zt-chen/voltpillager/docs/README.md

# Voltpillager Website 

Voltpillager Website build with cayman theme
