zt-chen/voltpillager/additional/stability/stability.pdf

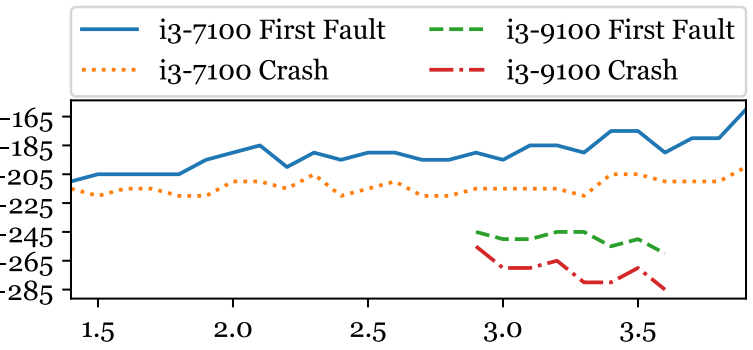
[picture p9: figure]
i3-7100 First Fault i3-7100 Crash; i3-9100 First Fault i3-9100 Crash

### Frequency (GHz)

### Undervolting (mV)
