zt-chen/voltpillager/docs/voltpillager-photo.jpeg

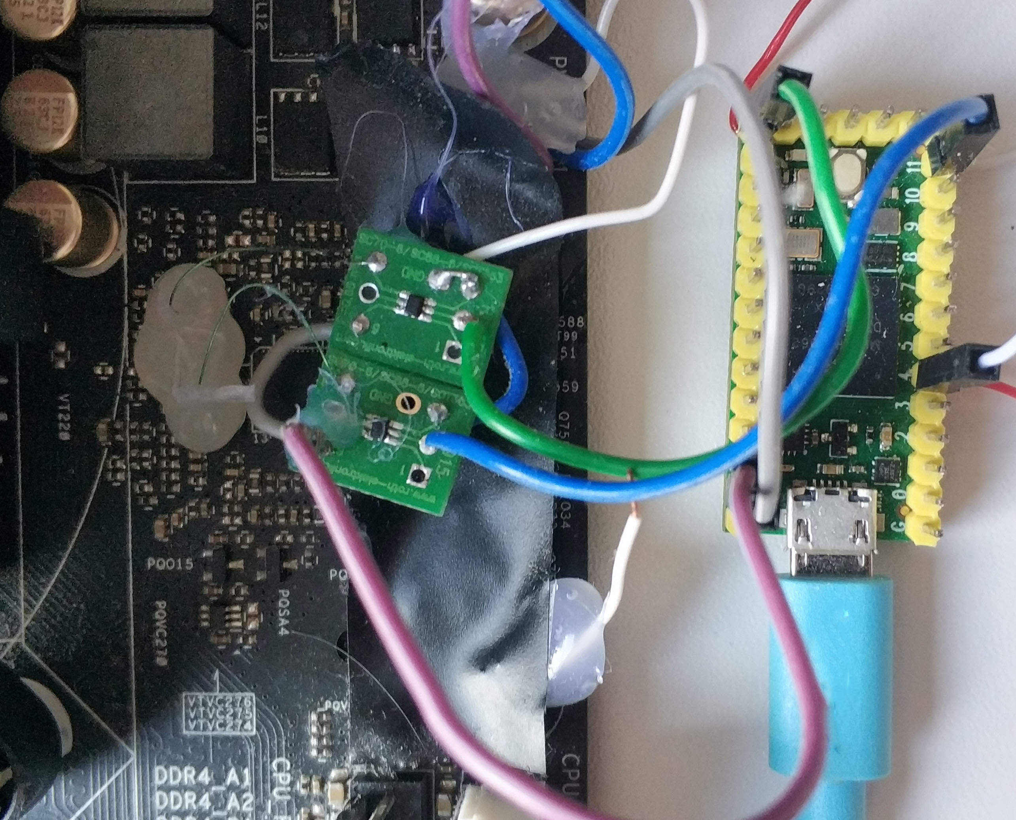
docs/voltpillager-photo.jpeg
