zt-chen/voltpillager/(threads)

Thread 1 (2020-12-04):

A question for Voltpillager Board

LordCasser, 2020-12-04:
I'm trying to build the Voltpillager Board,but I have no idea what is J1~J7? How can I get them?

zt-chen, 2020-12-04:
J1-J7 are just connection points. You can just use wires or some connection header such as this one: https://www.amazon.co.uk/Pack-Single-2-54-Header-Connector/dp/B06XR8CV8P/

LordCasser, 2020-12-05:
Thanks a lot

Closed 2020-12-05.

Thread 2 (2022-04-04):

Wrong bus drivers recommended?

Bukl198, 2022-04-04:
Hi there,

I noticed that the bus drivers that are recommended by you only work in the range of vcc = 1.65v to 5.5v.

However, the operating voltage for svid bus is 1v hence there is a mismatch. Will it still work if i supplied 1.65v to the bus drivers?

Thank you.

Bukl198, 2022-04-14:
Ahhh i see thank you for your explanation. Also how do I probe for the voltage of the cpu using an oscilloscope? Is there an additional pin on the VR chip that outputs the voltage? I am using the same intel NUC that you have in your research paper for reference.

zt-chen, 2022-04-14:
The maybe a pin for voltage sensing on the VR, but the location I used is one of the big capacitors/inductors around the CPU since it's easier to solder a wire on it. Usually, there are two pins that connect the cap, one is GND the other is Vcpu.

Closed 2022-04-14.
