zt-chen/voltpillager/VoltPillager-board/main.pdf

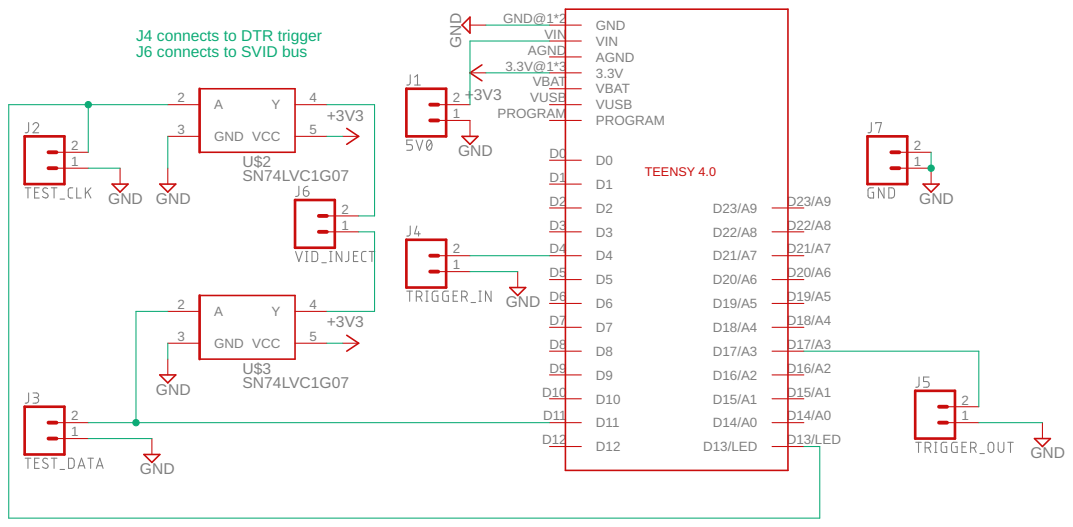
[picture p11: page 1]
