zt-chen/voltpillager/VoltPillager-board/main.sch

## EAGLE design VoltPillager-board/main.sch (2020-11-12)

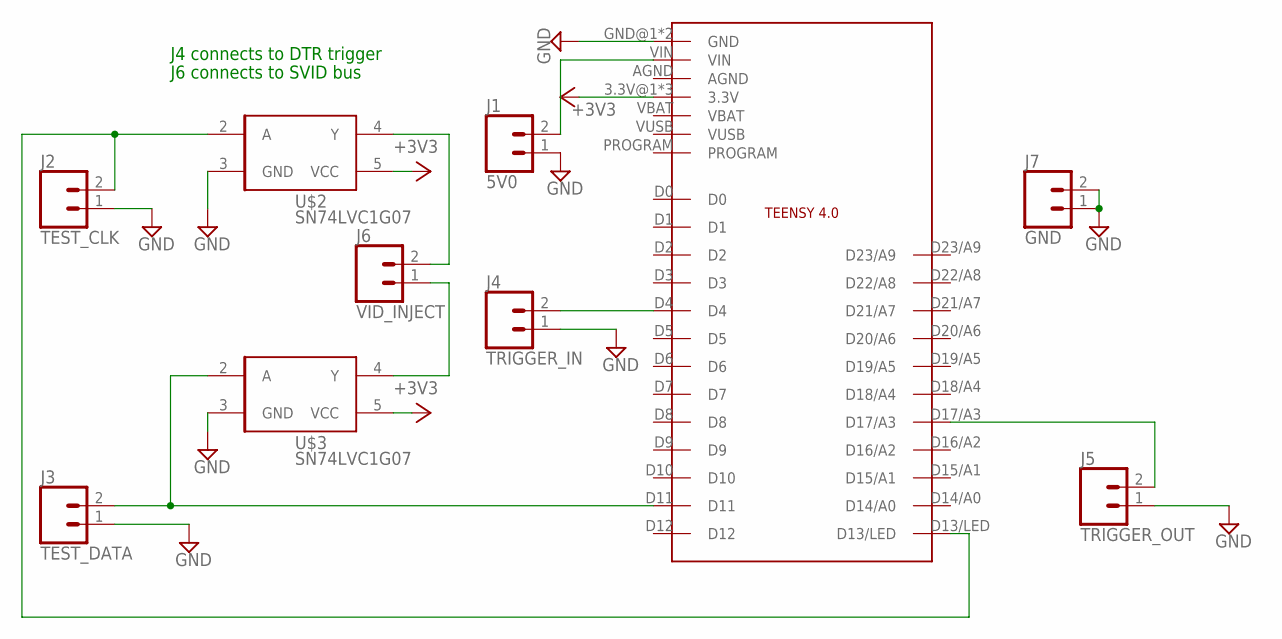
[picture p12: schematic main.sch]

Parts:
J1: 5V0; 1X02
J2: TEST_CLK; 1X02
J3: TEST_DATA; 1X02
J4: TRIGGER_IN; 1X02
J5: TRIGGER_OUT; 1X02
J6: VID_INJECT; 1X02
J7: GND; 1X02
U$1: TEENSY4.0
U$2, U$3: SN74LVC1G07; SOT353-1

Connections:
+3V3: U$1.3.3V@1 (3.3V), U$2.5 (VCC), U$3.5 (VCC)
GND: J1.1, J2.1, J3.1, J4.1, J5.1, J7.1, J7.2, U$1.GND@1 (GND), U$2.3 (GND), U$3.3 (GND)
unnamed: J4.2, U$1.D4
unnamed: J3.2, U$1.D11, U$3.2 (A)
unnamed: J1.2, U$1.VIN
unnamed: J6.1, U$3.4 (Y)
unnamed: J6.2, U$2.4 (Y)
unnamed: J5.2, U$1.D17/A3
N_CLK: J2.2, U$1.D13/LED, U$2.2 (A)

Notes on the sheet:
J6 connects to SVID bus
J4 connects to DTR trigger
